raymanx51/Low-Cost-EEG-Based-BCI/Circuit/EEG_sch.pdf

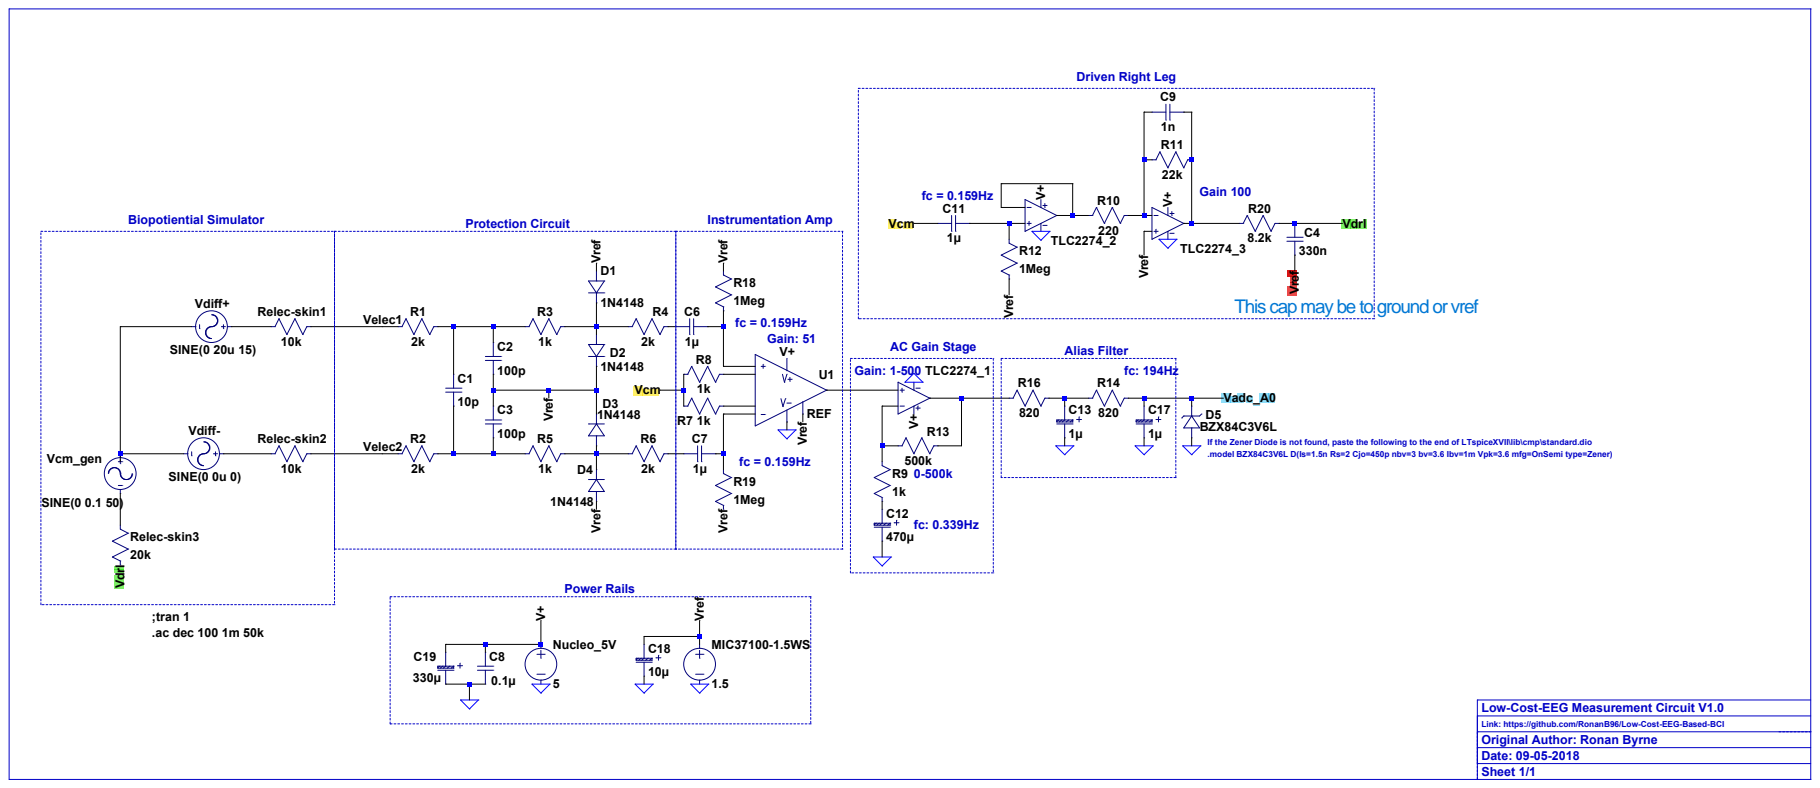
[picture p1: page 1]

R18 1Meg

Gain: 1-500 TLC2274_1 0-500k | fc: 194Hz R16 R14

If the Zener Diode is not found, paste the following to the end of LTspiceXVII\lib\cmp\standard.dio
.model BZX84C3V6L D(Is=1.5n Rs=2 Cjo=450p nbv=3 bv=3.6 Ibv=1m Vpk=3.6 mfg=OnSemi type=Zener)

Low-Cost-EEG Measurement Circuit V1.0

Link: https://github.com/RonanB96/Low-Cost-EEG-Based-BCI
Original Author: Ronan Byrne
Date: 09-05-2018
Sheet 1/1
