raymanx51/Low-Cost-EEG-Based-BCI/Circuit/opto_iso_sch.pdf

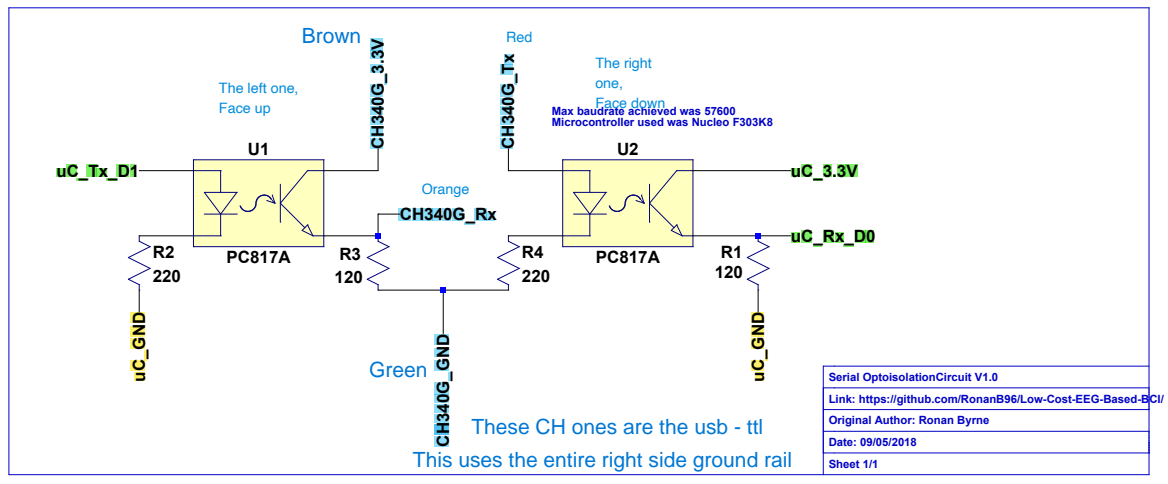
[picture p2: page 1]
uC_GND; CH340G_GND; Date: 09/05/2018; Sheet 1/1; Serial OptoisolationCircuit V1.0

Max baudrate achieved was 57600
Microcontroller used was Nucleo F303K8

Link: https://github.com/RonanB96/Low-Cost-EEG-Based-BCI/

Original Author: Ronan Byrne
