raymanx51/Low-Cost-EEG-Based-BCI/Nucleo Code/currentBest/Core/Src/main.c

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
/* Includes ------------------------------------------------------------------*/
#include "main.h"

/* USER CODE BEGIN Includes */
#include <string.h>
#include <stdio.h>


/* USER CODE END Includes */

 ADC_HandleTypeDef hadc1;

UART_HandleTypeDef huart1;
UART_HandleTypeDef huart2;

void SystemClock_Config(void);
static void MX_GPIO_Init(void);
static void MX_USART2_UART_Init(void);
static void MX_ADC1_Init(void);
static void MX_USART1_UART_Init(void);
/**
  * @brief  The application entry point.
  * @retval int
  */
int main(void)
{
  /* USER CODE BEGIN 1 */

	uint16_t raw;
	char msg[10];


  /* USER CODE END 1 */

  /* MCU Configuration--------------------------------------------------------*/

  /* Reset of all peripherals, Initializes the Flash interface and the Systick. */
  HAL_Init();

  /* Configure the system clock */
  SystemClock_Config();

  /* Initialize all configured peripherals */
  MX_GPIO_Init();
  MX_USART2_UART_Init();
  MX_ADC1_Init();
  MX_USART1_UART_Init();
  /* Infinite loop */
  /* USER CODE BEGIN WHILE */
  while (1)
  {
	// HAL_GPIO_WritePin(GPIOA, GPIO_PIN_10, GPIO_PIN_SET);
	// HAL_GPIO_TogglePin(LED_GPIO_Port, LED_Pin);

	HAL_ADC_Start(&hadc1);
	HAL_ADC_PollForConversion(&hadc1, HAL_MAX_DELAY);

	raw = HAL_ADC_GetValue(&hadc1);

	// HAL_GPIO_WritePin(GPIOA, GPIO_PIN_10, GPIO_PIN_RESET);

	// HAL_GPIO_TogglePin(LED_GPIO_Port, LED_Pin);

	sprintf(msg, "%hu\r\n", raw);
	HAL_UART_Transmit(&huart2, (uint8_t*)msg, strlen(msg), HAL_MAX_DELAY);
	HAL_UART_Transmit(&huart1, (uint8_t*)msg, strlen(msg), HAL_MAX_DELAY);

	HAL_Delay(1);
    /* USER CODE END WHILE */

    /* USER CODE BEGIN 3 */
  }
  /* USER CODE END 3 */
}

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
