raymanx51/Low-Cost-EEG-Based-BCI/Nucleo Code/EEG/OriginalStructure/Core/Src/main.c

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
/* Includes ------------------------------------------------------------------*/
#include "main.h"
/*
#include "stm32f3xx_hal.h"
#include "stm32f3xx_hal_adc.h"

#include "stm32f3xx_hal_adc.c"
#include "stm32f3xx_hal_adc_ex.c"
*/


/* USER CODE BEGIN Includes */
/*
 * main.c
 *
 * This code measures the output from a bioamplifier circuit
 * and sends the values over to a PC over USART.
 * On startup, the code waits for the PC to tell it to start.
 *
 * Created By STM32CubeMX
 * Adapted By Ronan Byrne
 * Last Updated = 09/05/2018
 *
 */

#include <string.h>
#include "utils.h"

/* Enable Printing of Receive Messages From USART */
#define RECEIVE_PRINT_EN		0
#define ADC_BUFF_SIZE			512
#define ADC_BUFF_HALF_SIZE 		ADC_BUFF_SIZE/2
/* The offset is the size of adc array as this accounts for casting 16bit to 8bit int */
#define ADC_BUFF_OFFSET			ADC_BUFF_SIZE
#define UART_RX_BUFFER_SIZE		256
#define END_OF_MESSAGE_CHAR		'\n'
#define START_STR				"start\n"

/* USER CODE END Includes */

/* USER CODE BEGIN PTD */
ADC_HandleTypeDef hadc1;
DMA_HandleTypeDef hdma_adc1;

TIM_HandleTypeDef htim3;

UART_HandleTypeDef huart1;
DMA_HandleTypeDef hdma_usart1_tx;
DMA_HandleTypeDef hdma_usart1_rx;

/* USER CODE END PTD */

UART_HandleTypeDef huart2;

/* USER CODE BEGIN PV */
/* __IO is volatile in HAL library */
__IO uint8_t *print_str_ptr = NULL;
__IO uint16_t adc_val[ADC_BUFF_SIZE] = { 0 }; /* Where the ADC values are stored */
__IO uint16_t adc_array_offset = 0; /* Offset for sending first or second half of ADC buffer */
__IO uint8_t adc_print = 0; /* Print adc values flag */
__IO uint8_t str_print = 0; /* Print string flag */
__IO uint8_t end_of_message = 0; /* Flag is set when start of string has be sent */
__IO uint8_t start = 0; /* Flag to start main loop after receiving response from PC */

uint8_t rx_buffer[UART_RX_BUFFER_SIZE] = { 0 }; /* Buffer for received messages over USART */
circle_buff_s rx_control = { /* Struct for managing receive buffer */.buffer = rx_buffer, .head = 0, .tail = 0, .size = UART_RX_BUFFER_SIZE,
		.wrapped = 0 };

/* USER CODE END PV */

static void MX_USART2_UART_Init(void);

void SystemClock_Config(void);
static void MX_GPIO_Init(void);
static void MX_DMA_Init(void);
static void MX_USART1_UART_Init(void);
static void MX_ADC1_Init(void);
static void MX_TIM3_Init(void);
/**
 * @brief  The application entry point.
 * @retval int
 */
int main(void) {
	/* MCU Configuration--------------------------------------------------------*/

	/* Reset of all peripherals, Initializes the Flash interface and the Systick. */
	HAL_Init();

	/* Configure the system clock */
	SystemClock_Config();

	/* Initialize all configured peripherals */

	MX_USART2_UART_Init();
	MX_GPIO_Init();
	MX_DMA_Init();
	MX_USART1_UART_Init();
	MX_ADC1_Init();
	MX_TIM3_Init();

	/* USER CODE BEGIN 2 */

	/* Enable interrupt on single Byte receive in USART buffer */
	__HAL_UART_ENABLE_IT(&huart1, UART_IT_RXNE);

	/* Workaround for asynchronous UART RX */
	huart1.pRxBuffPtr = rx_control.buffer; /* Tell USART where to place received bytes */
	huart1.Mask = 0xFFU; /* Setting no parity bits */

	/* USER CODE END 2 */

	/* USER CODE BEGIN WHILE */

	/* Loop around until "start\n" is received over USART */
	while (!start) {
		HAL_printf("s"); /* Send "ss/n" over USART */
		HAL_Delay(500); /* Delay 500ms */
	}
	/* Received start from PC, acknowledge and start */
	HAL_printf("starting");

	/* Calibrate ADC */
	HAL_Status_Check(HAL_ADCEx_Calibration_Start(&hadc1, ADC_SINGLE_ENDED));

	/* Start DMA controller taking samples from ADC and placing them in buffer */
	HAL_Status_Check(
			HAL_ADC_Start_DMA(&hadc1, (uint32_t*) &adc_val, ADC_BUFF_SIZE));

	/* Start timer used to trigger ADC conversions, timer set to 1KHz */
	HAL_Status_Check(HAL_TIM_Base_Start_IT(&htim3));

	/* Main Loop, sends the half the ADC buffer every 256ms and can send received messaged if enabled */

	while (1) {
		/* USER CODE END WHILE */
		/* ADC values ready to send */
		if (adc_print) {
			/* This is actually sending half of the ADC buffer because of the cast, 512 uin8_t's or 256 uint16_t's */
			HAL_print_raw((uint8_t*) (&adc_val) + adc_array_offset,
			ADC_BUFF_SIZE);
			adc_print = 0;
		}
		/* Received message over USART, print it back */
		if (str_print && RECEIVE_PRINT_EN) {
			/* Full message received, send in one go */
			if (!end_of_message) {
				HAL_printf("Received %s", print_str_ptr);
			}
			/* Start of message already sent, print end of message */
			else {
				HAL_print_raw((uint8_t*) print_str_ptr, rx_control.head);
				HAL_print_raw((uint8_t*) '\n', 1);
				end_of_message = 0;
			}
			str_print = 0;
			/* USER CODE BEGIN 3 */
		}
		/* USER CODE END 3 */
	}
}

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
/* USER CODE BEGIN 4 */

/* Called When the ADC has filled half of the buffer */
void HAL_ADC_ConvHalfCpltCallback(ADC_HandleTypeDef *hadc) {
	/* Set flag to send first half of buffer */
	adc_print = 1;
	adc_array_offset = 0;
}

/* Called when the ADC has filled the buffer */
void HAL_ADC_ConvCpltCallback(ADC_HandleTypeDef *hadc) {
	/* Set flag to send second half of buffer */
	adc_print = 1;
	adc_array_offset = ADC_BUFF_OFFSET;
	/* Tell DMA controller to restart filling the buffer */
	HAL_Status_Check(
			HAL_ADC_Start_DMA(&hadc1, (uint32_t*) &adc_val, ADC_BUFF_SIZE));
}

/* Called when the UART has processed 1 byte, had to implement my own circular buffer this way
 * as HAL library didn't facilitate asynchronous receiving
 */
void HAL_UART_RxCpltCallback(UART_HandleTypeDef *huart) {
	/* End of buffer, print start of message */
	if ((uint32_t) huart->pRxBuffPtr
			>= ((uint32_t) (rx_control.buffer) + rx_control.size - 1)) {
		print_str_ptr = rx_control.buffer + rx_control.tail;
		huart->pRxBuffPtr = rx_control.buffer;
		rx_control.head = 0;
		rx_control.tail = 0;
		rx_control.wrapped = 1;
		str_print = 1;
	} else {
		rx_control.head++;
	}

	/* Full message received, process it */
	if ((uint8_t) *(rx_control.buffer + rx_control.head - 1)
			== (uint8_t) END_OF_MESSAGE_CHAR) {
		/* Don't set print_str_ptr if it was set already above */
		if (!str_print) {
			print_str_ptr = rx_control.buffer + rx_control.tail;
			if (RECEIVE_PRINT_EN) {
				str_print = 1;
			}
		}

		/* Start message received from PC, start main loop */
		if (!start
				&& !(strncmp((char*) print_str_ptr, START_STR,
						strlen(START_STR)))) {
			start = 1;
		}
		rx_control.tail = rx_control.head;

		/* If receive buffer has wrapped around, print end of message and memset rest of buffer */
		if (rx_control.wrapped) {
			rx_control.wrapped = 0;
			/* memset everything after current message */
			memset(rx_control.buffer + rx_control.tail, 0,
					rx_control.size - rx_control.tail);
			end_of_message = 1;
		}
	}

	/* Re-enable byte received interrupt */
	__HAL_UART_ENABLE_IT(huart, UART_IT_RXNE);
}
/* USER CODE END 4 */


void _Error_Handler(char *file, int line) {
	/* USER CODE BEGIN Error_Handler_Debug */
	/* User can add his own implementation to report the HAL error return state */
	while (1) {
	}
	/* USER CODE END Error_Handler_Debug */
}

/**
 * @brief  This function is executed in case of error occurrence.
 * @retval None
 */

void Error_Handler(void) {
	/* USER CODE BEGIN Error_Handler_Debug */
	/* User can add his own implementation to report the HAL error return state */
	__disable_irq();
	while (1) {
	}
	/* USER CODE END Error_Handler_Debug */
}

#ifdef  USE_FULL_ASSERT
/**
  * @brief  Reports the name of the source file and the source line number
  *         where the assert_param error has occurred.
  * @param  file: pointer to the source file name
  * @param  line: assert_param error line source number
  * @retval None
  */
void assert_failed(uint8_t *file, uint32_t line)
{
  /* USER CODE BEGIN 6 */
  /* User can add his own implementation to report the file name and line number,
     ex: printf("Wrong parameters value: file %s on line %d\r\n", file, line) */
  /* USER CODE END 6 */
}
#endif /* USE_FULL_ASSERT */
