raymanx51/Low-Cost-EEG-Based-BCI/(notices)

Notices in the files:
Nucleo Code/currentBest/Core/Src/main.c:
Copyright (c) 2022 STMicroelectronics.
All rights reserved.
This software is licensed under terms that can be found in the LICENSE file
